Pizmuh/3D_Scanner/Arduino_code/README.md

# 3D_laserski_merilnik

Izdelava 3D skennerja z laserskim merilcem dolžine
