Pizmuh/3D_Scanner/3D skener.pptx

## 3D skener

Simon Lipovšek

## 3D skener

Namen
Delovanje
Sestavni deli
Postopek dela

Presentation Title

## Sestavni deli

- 3D modeli
- Laserski merilnik
- Arduino
- 2 x Servo motorja
- SD modul
- Dodatki

## Izdelava

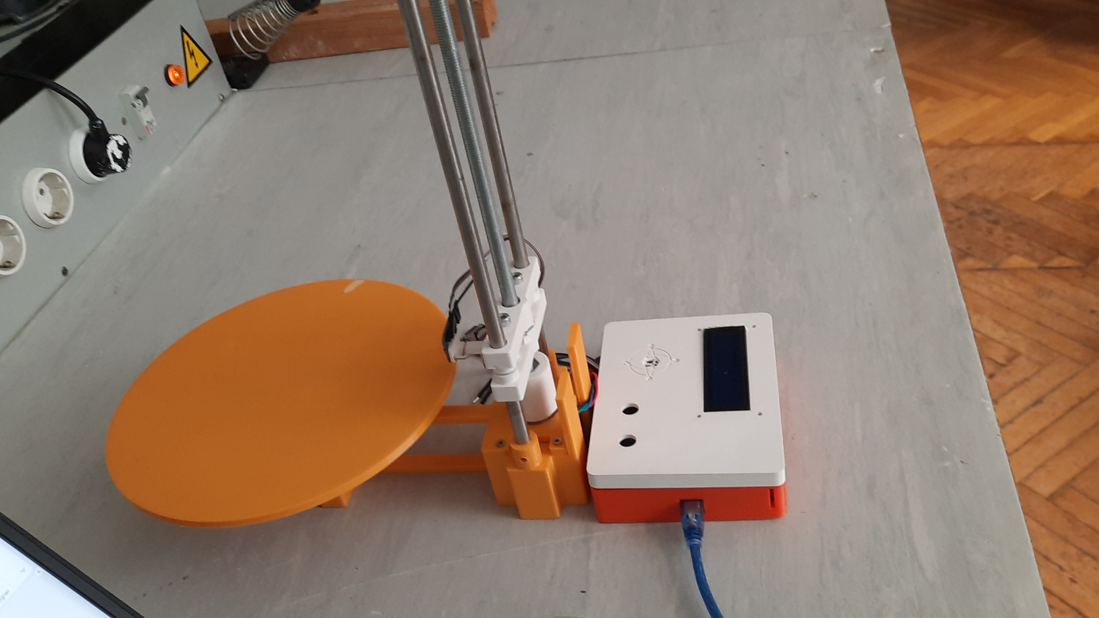
[picture p1: figure]

## 3D model

- Velikosti
- Spremembe
- Problemi s podlago
- Drsnik

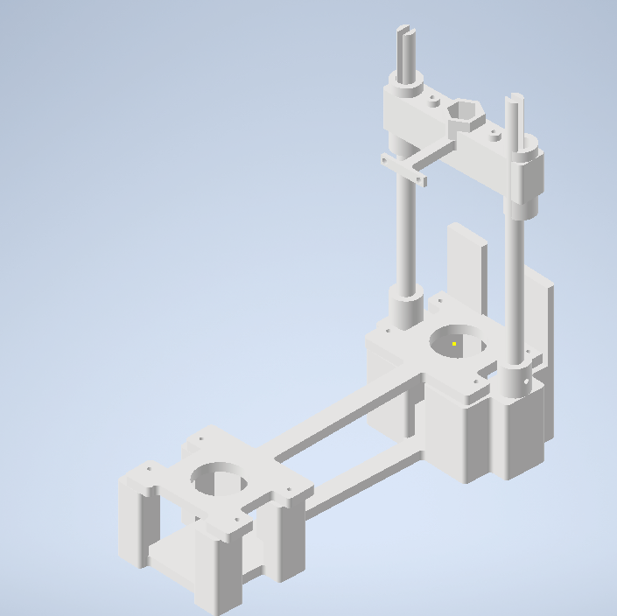
[picture p2: figure]

## MeshLab

- Preostre točke
- Tvorjenje površine

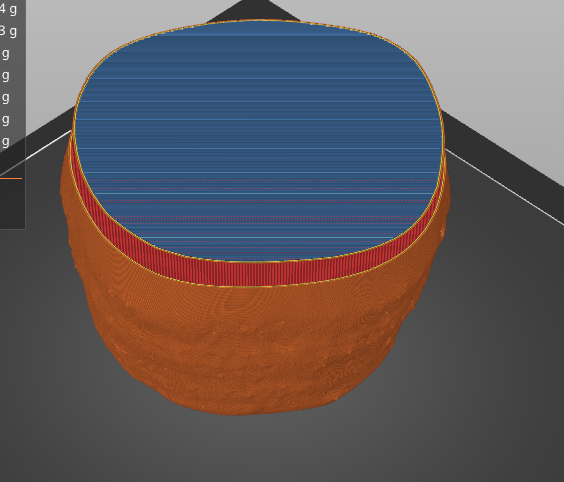
[picture p3: figure]
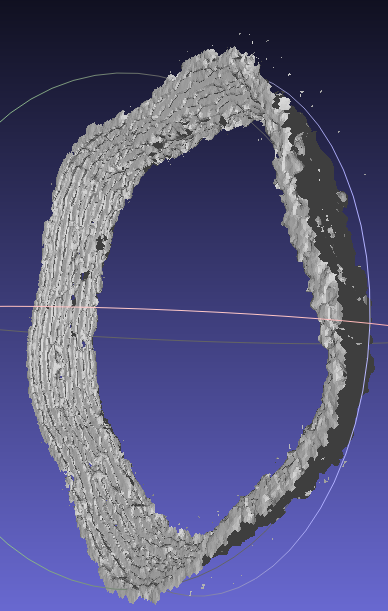
[picture p4: figure]
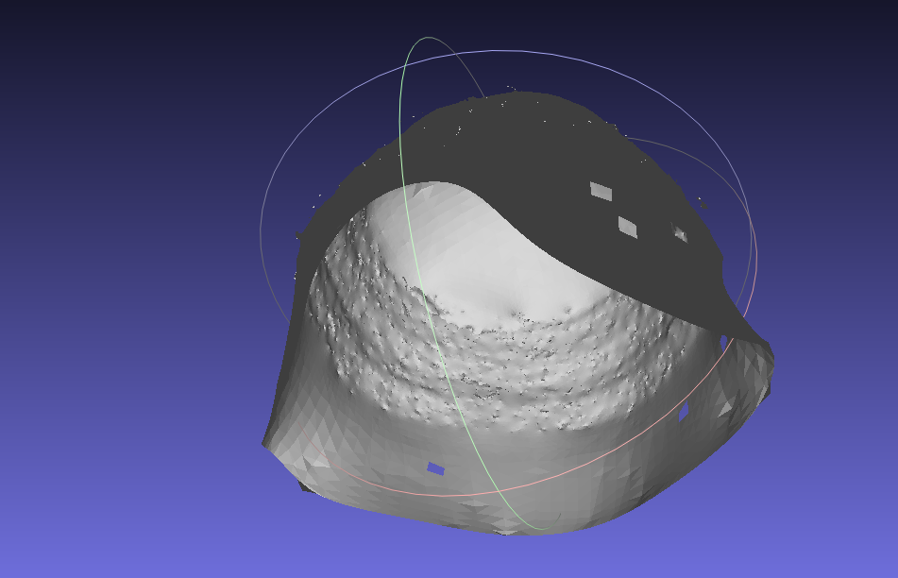
[picture p5: figure]

## Delovanje

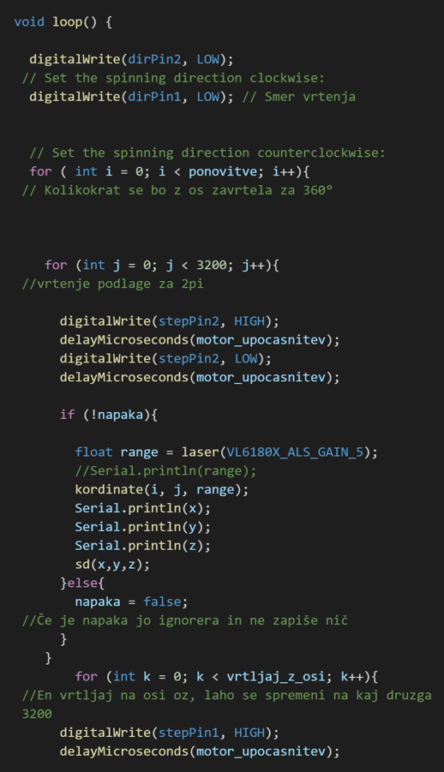
[picture p6: figure]

- Mesheye
- Arduino program
- Kotne funkcije

## Namen

- Izdelava iz drugih materialov
- Poceni
- Prilagodljiv
