Pizmuh/3D_Scanner/3D model/3D_skenner/Design Accelerator/Spur Gear11.stl

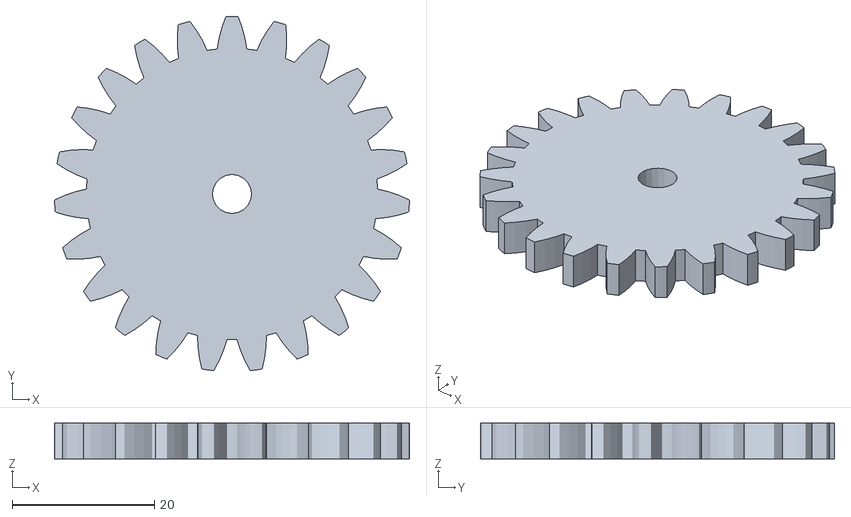
[picture p18: CAD file, 2023-05-20]
3D model/3D_skenner/Design Accelerator/Spur Gear11.stl
50.0 x 49.9 x 5.00
