Pizmuh/3D_Scanner/3D model/Ogrodje_spodaj_2.3.stl

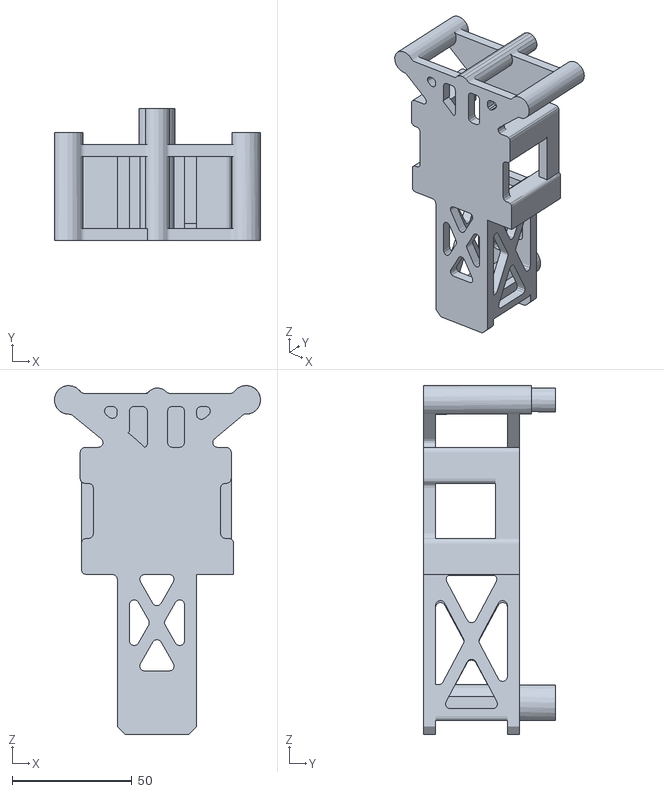
[picture p19: CAD file, 2023-05-20]
3D model/Ogrodje_spodaj_2.3.stl
86.0 x 55.0 x 145.6
