Pizmuh/3D_Scanner/3D model/3D_skenner/Design Accelerator/Spur Gear21.stl

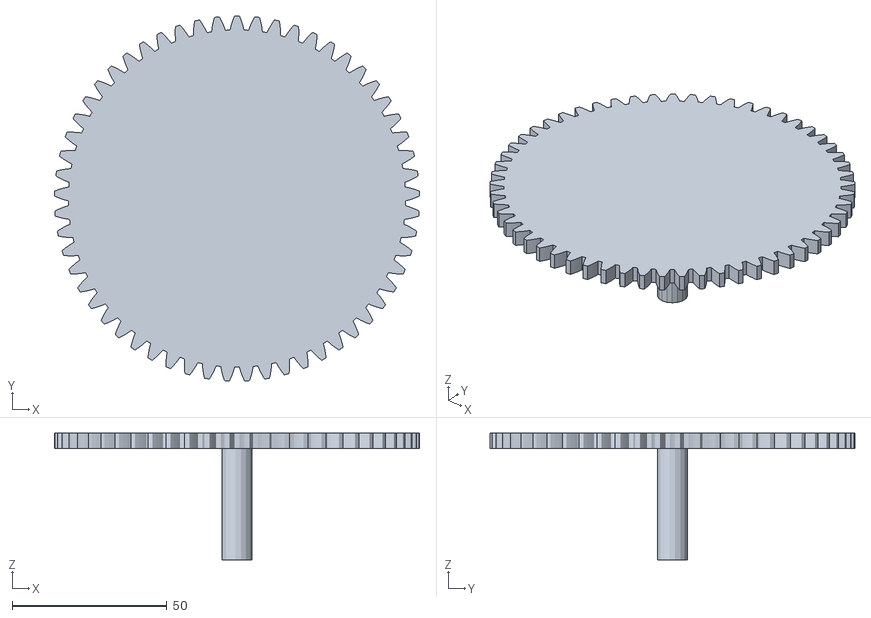
[picture p20: CAD file, 2023-05-20]
3D model/3D_skenner/Design Accelerator/Spur Gear21.stl
118.0 x 117.9 x 41.0
