Pizmuh/3D_Scanner/3D model/Drzalo_motorja_2.stl

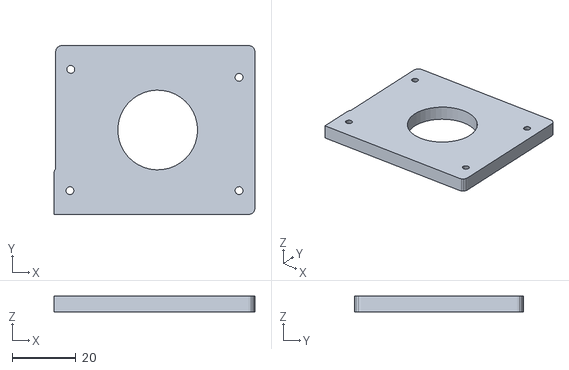
[picture p21: CAD file, 2023-05-20]
3D model/Drzalo_motorja_2.stl
63.0 x 53.0 x 5.00
