Pizmuh/3D_Scanner/3D model/3D_skenner/Design Accelerator/Spur Gear_22.stl

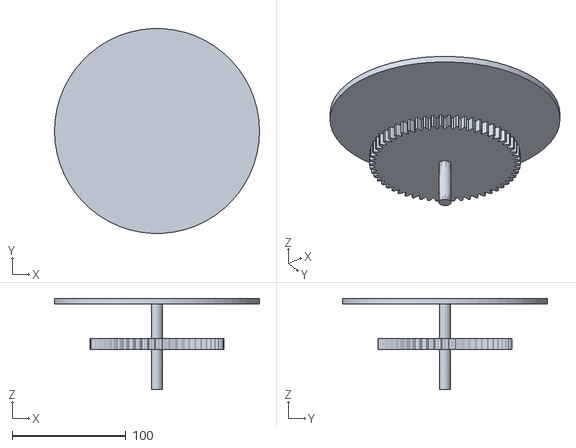
[picture p22: CAD file, 2023-05-20]
3D model/3D_skenner/Design Accelerator/Spur Gear_22.stl
180.0 x 179.7 x 80.0
