Pizmuh/3D_Scanner/3D model/Ogrodje_spodaj_2.2.stl

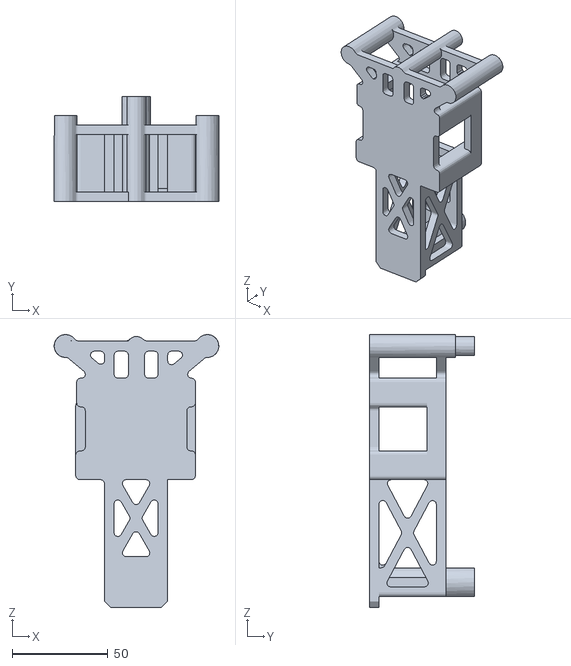
[picture p23: CAD file, 2023-05-20]
3D model/Ogrodje_spodaj_2.2.stl
86.0 x 55.0 x 142.5
