Pizmuh/3D_Scanner/3D model/3D_skenner/Design Accelerator/Spur Gears_2.0.stl

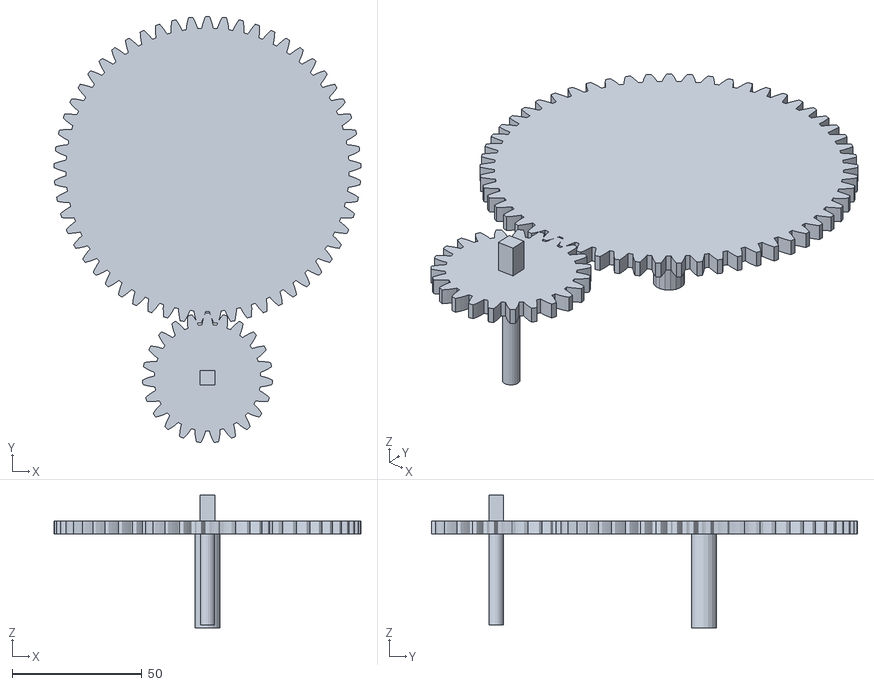
[picture p24: CAD file, 2023-05-20]
3D model/3D_skenner/Design Accelerator/Spur Gears_2.0.stl
118.0 x 163.9 x 51.0
