Pizmuh/3D_Scanner/3D model/držalo_laserja_2.6.stl

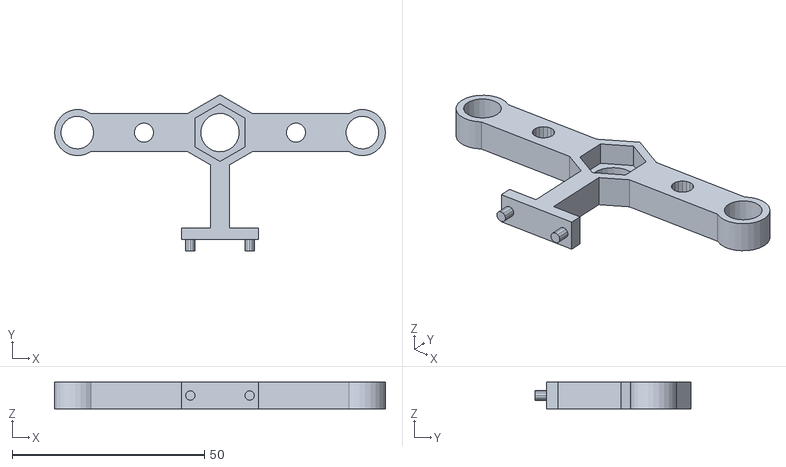
[picture p25: CAD file, 2023-05-20]
3D model/držalo_laserja_2.6.stl
86.0 x 40.6 x 7.00
