Pizmuh/3D_Scanner/3D model/Drzalo_motorja_2.0.stl

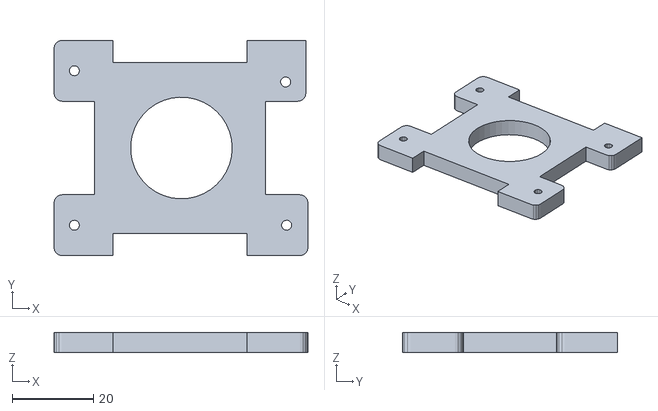
[picture p27: CAD file, 2023-05-20]
3D model/Drzalo_motorja_2.0.stl
62.5 x 53.0 x 5.00
