Pizmuh/3D_Scanner/3D model/3D_skenner/Design Accelerator/Small_Spur Gear_2.0.stl

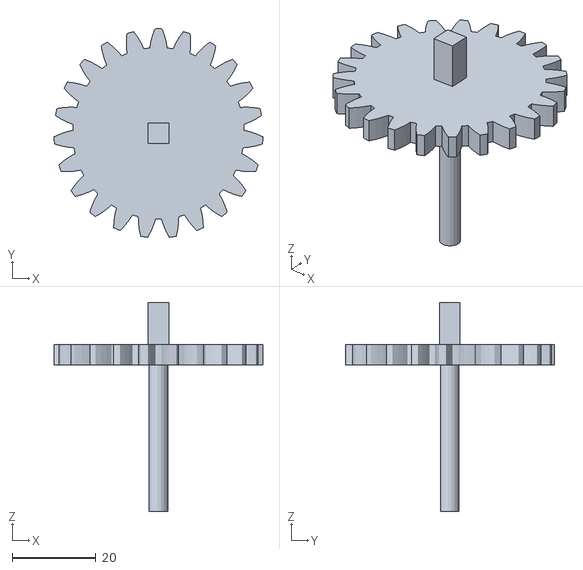
[picture p28: CAD file, 2023-05-20]
3D model/3D_skenner/Design Accelerator/Small_Spur Gear_2.0.stl
50.0 x 49.9 x 50.0
