Pizmuh/3D_Scanner/3D model/Ogrodje_spodaj_1.stl

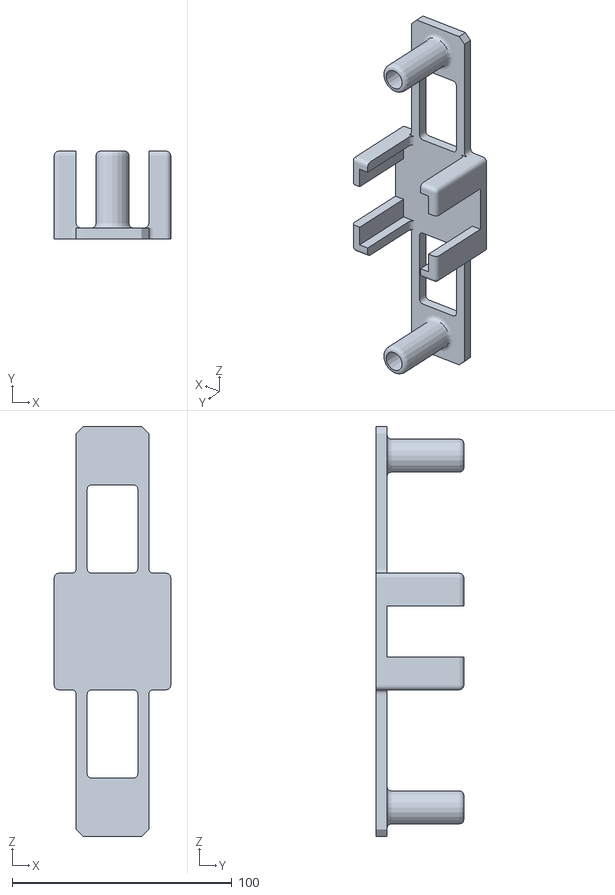
[picture p29: CAD file, 2023-05-20]
3D model/Ogrodje_spodaj_1.stl
53.0 x 40.0 x 186.5
