Pizmuh/3D_Scanner/3D model/test_izbrisi_1.stl

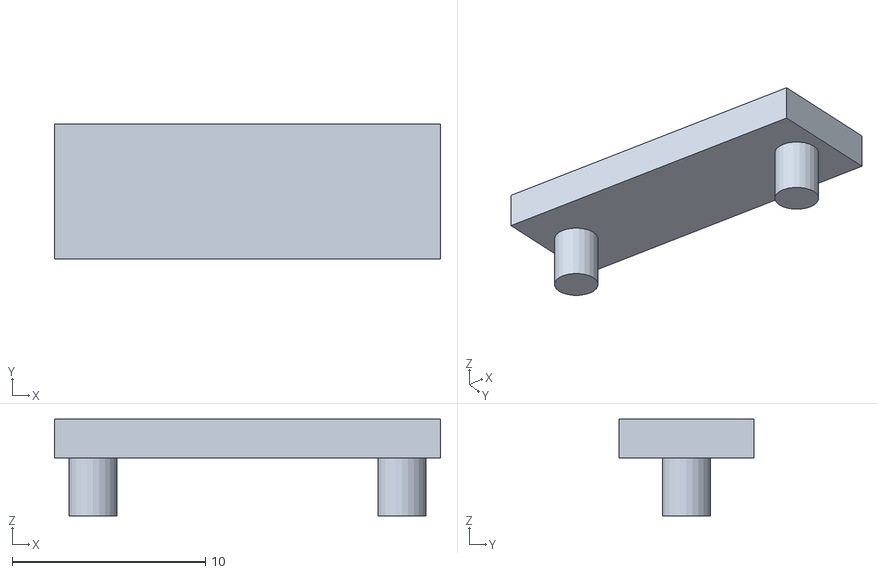
[picture p30: CAD file, 2023-05-20]
3D model/test_izbrisi_1.stl
20.0 x 7.00 x 5.00
