Pizmuh/3D_Scanner/3D model/3D_skenner/Design Accelerator/Spur Gears1.stl

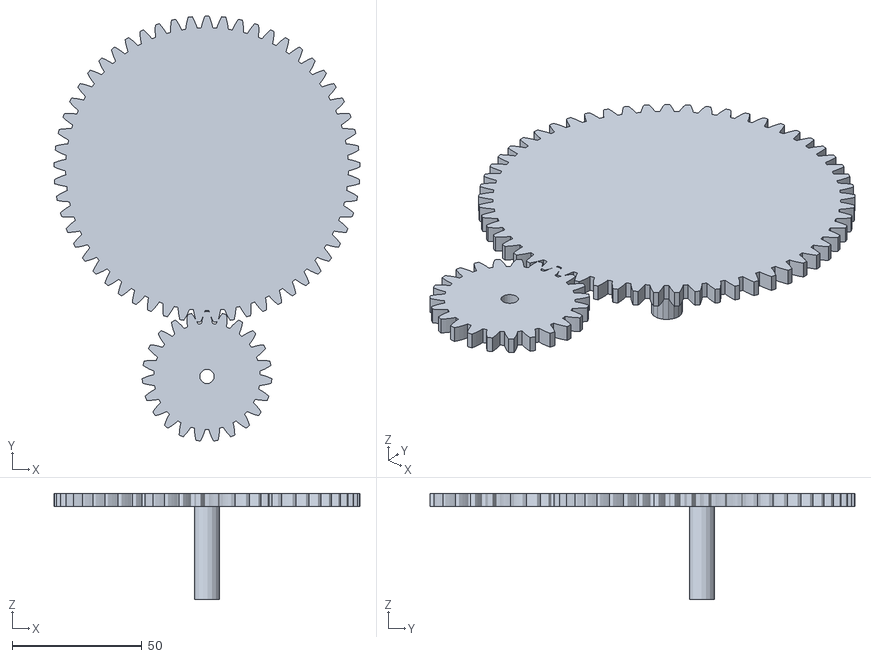
[picture p31: CAD file, 2023-05-20]
3D model/3D_skenner/Design Accelerator/Spur Gears1.stl
118.0 x 163.9 x 41.0
