Pizmuh/3D_Scanner/3D model/Ogrodje_spodaj_2.0.stl

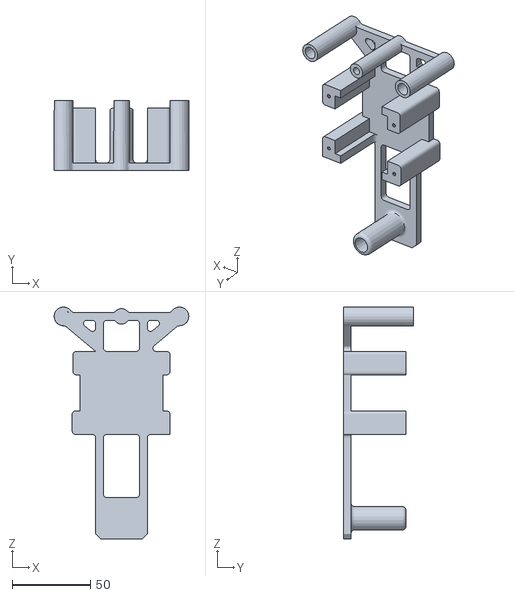
[picture p32: CAD file, 2023-05-20]
3D model/Ogrodje_spodaj_2.0.stl
86.0 x 45.0 x 148.1
