Pizmuh/3D_Scanner/3D model/3D_skenner/Design Accelerator/Spursmall_motor_gear_2.1.stl

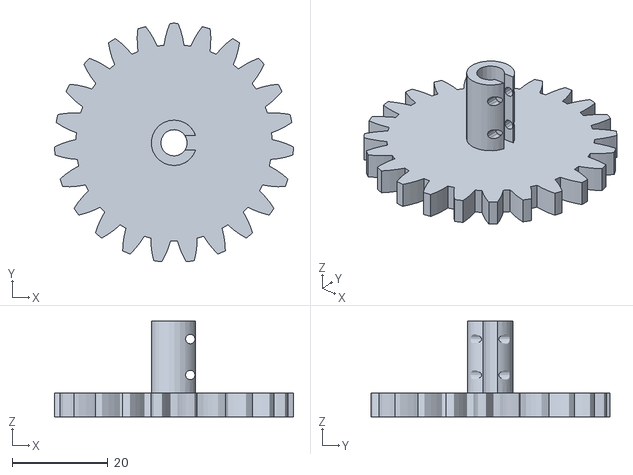
[picture p33: CAD file, 2023-05-20]
3D model/3D_skenner/Design Accelerator/Spursmall_motor_gear_2.1.stl
50.0 x 49.9 x 20.0
