Pizmuh/3D_Scanner/3D model/neki_neki.stl

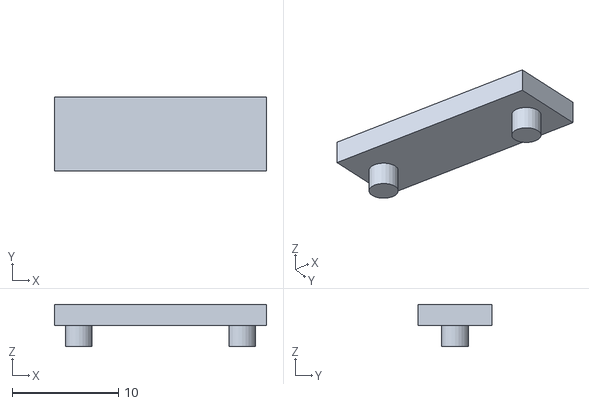
[picture p34: CAD file, 2023-05-20]
3D model/neki_neki.stl
20.0 x 7.00 x 4.00
