Pizmuh/3D_Scanner/3D model/3D_skenner/Design Accelerator/Spur Gear_2.0.stl

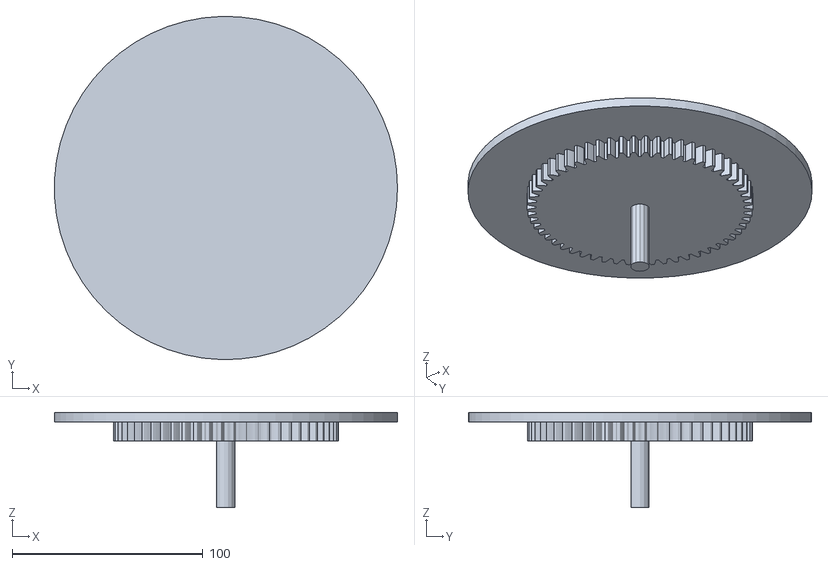
[picture p35: CAD file, 2023-05-20]
3D model/3D_skenner/Design Accelerator/Spur Gear_2.0.stl
179.9 x 179.9 x 50.0
