Pizmuh/3D_Scanner/3D model/chep_za_os_2.7.stl

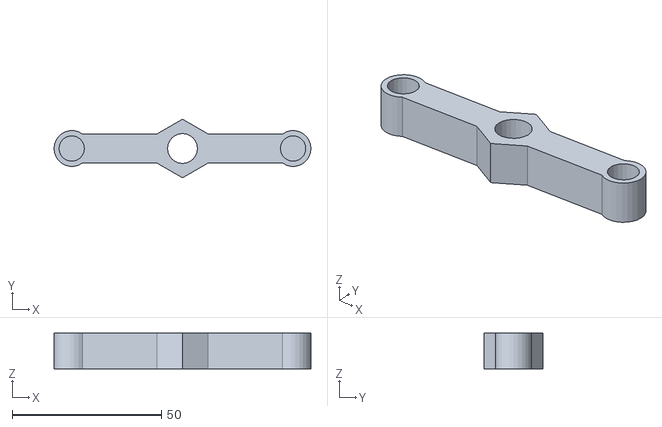
[picture p36: CAD file, 2023-05-20]
3D model/chep_za_os_2.7.stl
86.0 x 19.6 x 12.0
