Pizmuh/3D_Scanner/3D model/Ogrodje_spodaj_2.1.stl

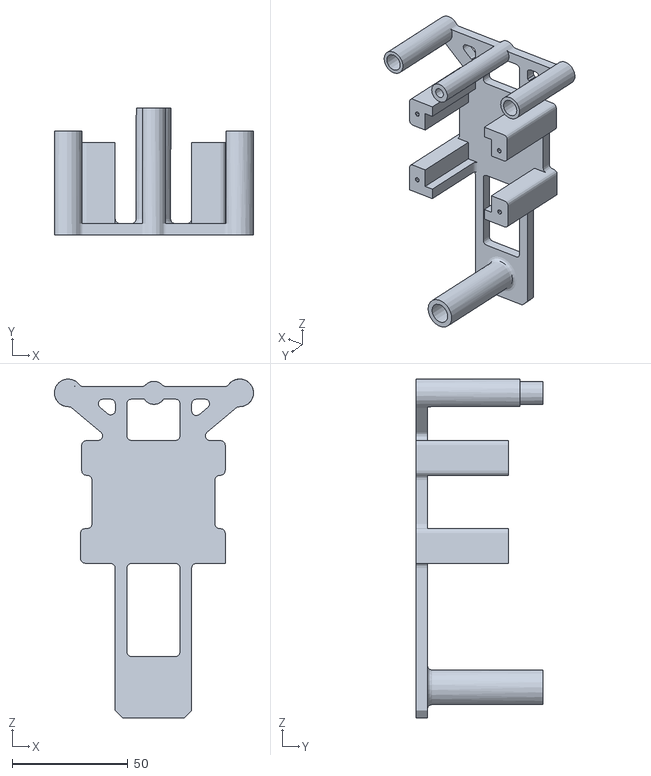
[picture p37: CAD file, 2023-05-20]
3D model/Ogrodje_spodaj_2.1.stl
86.0 x 55.0 x 146.3
