Pizmuh/3D_Scanner/3D model/Ogrodje_spodaj_2.4.stl

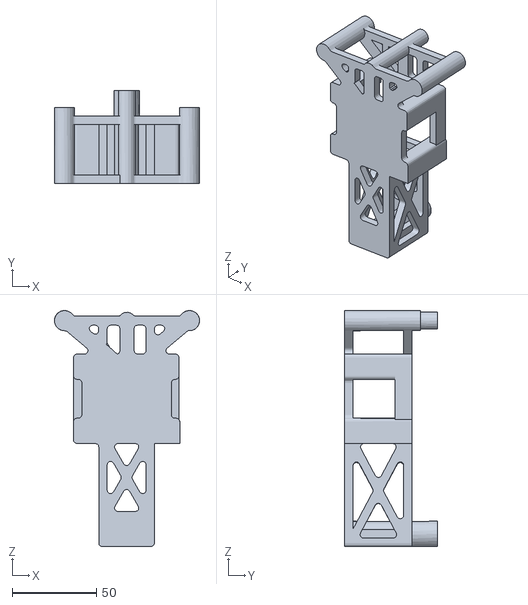
[picture p38: CAD file, 2023-05-20]
3D model/Ogrodje_spodaj_2.4.stl
86.0 x 55.0 x 139.8
