Pizmuh/3D_Scanner/3D model/chep_za_os_2.6.stl

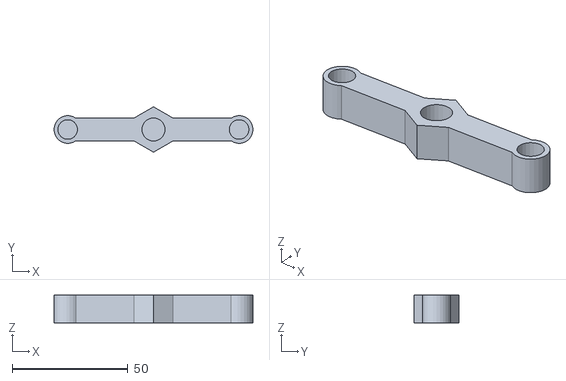
[picture p39: CAD file, 2023-05-20]
3D model/chep_za_os_2.6.stl
86.0 x 19.6 x 12.0
