Pizmuh/3D_Scanner/(list of files, cad)

Other CAD files:
3D model/3D_skenner/Design Accelerator/small spur gear_2.stl
3D model/Ogrodje_spodaj_1.4.stl
1. 3D model/Assembly1.iam
1. 3D model/Hold of motors.ipt
1. 3D model/constraining plate.ipt
1. 3D model/drzalo_vezja.ipt
1. 3D model/plošča za vrtenje.ipt
1. 3D model/podlaga_za_vrtrenje.ipt
1. 3D model/podn za vrtet.ipt
1. 3D model/priključek za matice.ipt
1. 3D model/priključek za na metice.ipt
1. 3D model/spirale.ipt
1. 3D model/zaponka za motor2.ipt
1. 3D model/zaponka za motorje.ipt
3D model/3D_skenner.iam
3D model/3D_skenner/Design Accelerator/Drzalo_motorja.ipt
3D model/3D_skenner/Design Accelerator/OldVersions/Spur Gear11.0004.ipt
3D model/3D_skenner/Design Accelerator/OldVersions/Spur Gear11_CPY.0001.ipt
3D model/3D_skenner/Design Accelerator/OldVersions/Spur Gear21_CPY.0001.ipt
3D model/3D_skenner/Design Accelerator/OldVersions/Spur Gears1.0003.iam
3D model/3D_skenner/Design Accelerator/OldVersions/Spur Gears1_CPY.0001.iam
3D model/3D_skenner/Design Accelerator/Spur Gear11.ipt
3D model/3D_skenner/Design Accelerator/Spur Gear11_CPY.ipt
3D model/3D_skenner/Design Accelerator/Spur Gear21.ipt
3D model/3D_skenner/Design Accelerator/Spur Gear21_CPY.ipt
3D model/3D_skenner/Design Accelerator/Spur Gears1.iam
3D model/3D_skenner/Design Accelerator/Spur Gears1_CPY.iam
3D model/Ogrodje_spodaj_1.ipt
3D model/OldVersions/3D_skenner.0016.iam
3D model/OldVersions/Ogrodje_spodaj_1.0008.ipt
3D model/OldVersions/Zobnik_na plošči.0001.ipt
3D model/OldVersions/motorni_zobnik.0001.ipt
3D model/OldVersions/test_izbrisi.0001.ipt
3D model/OldVersions/združevalnik_osi.0001.ipt
3D model/OldVersions/¸držalo_laserja.0006.ipt
3D model/chep_za_os.ipt
3D model/gears.ipt
3D model/motor_sample.ipt
3D model/motorni_zobnik.ipt
3D model/test_izbrisi.ipt
